kuon/pcb-pihat-pwr/README.md

## Simple power hat for the raspberry pi

This power hat provides 3A power to the raspberry pi from a 5-15V input with an
additional 5V 2A output.

Library footprint and symbols are from <https://github.com/goyman/pcb-kicad-lib>

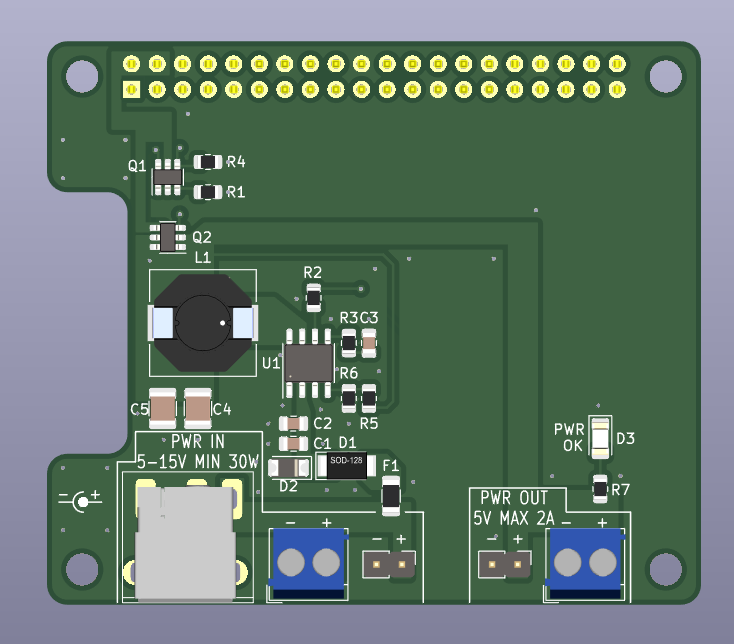
[picture p1: images/board.png]
board rev 1
