kuon/pcb-pihat-pwr/pcb-power-hat.kicad_pcb

## KiCad design pcb-power-hat.kicad_pcb (2022-10-22)

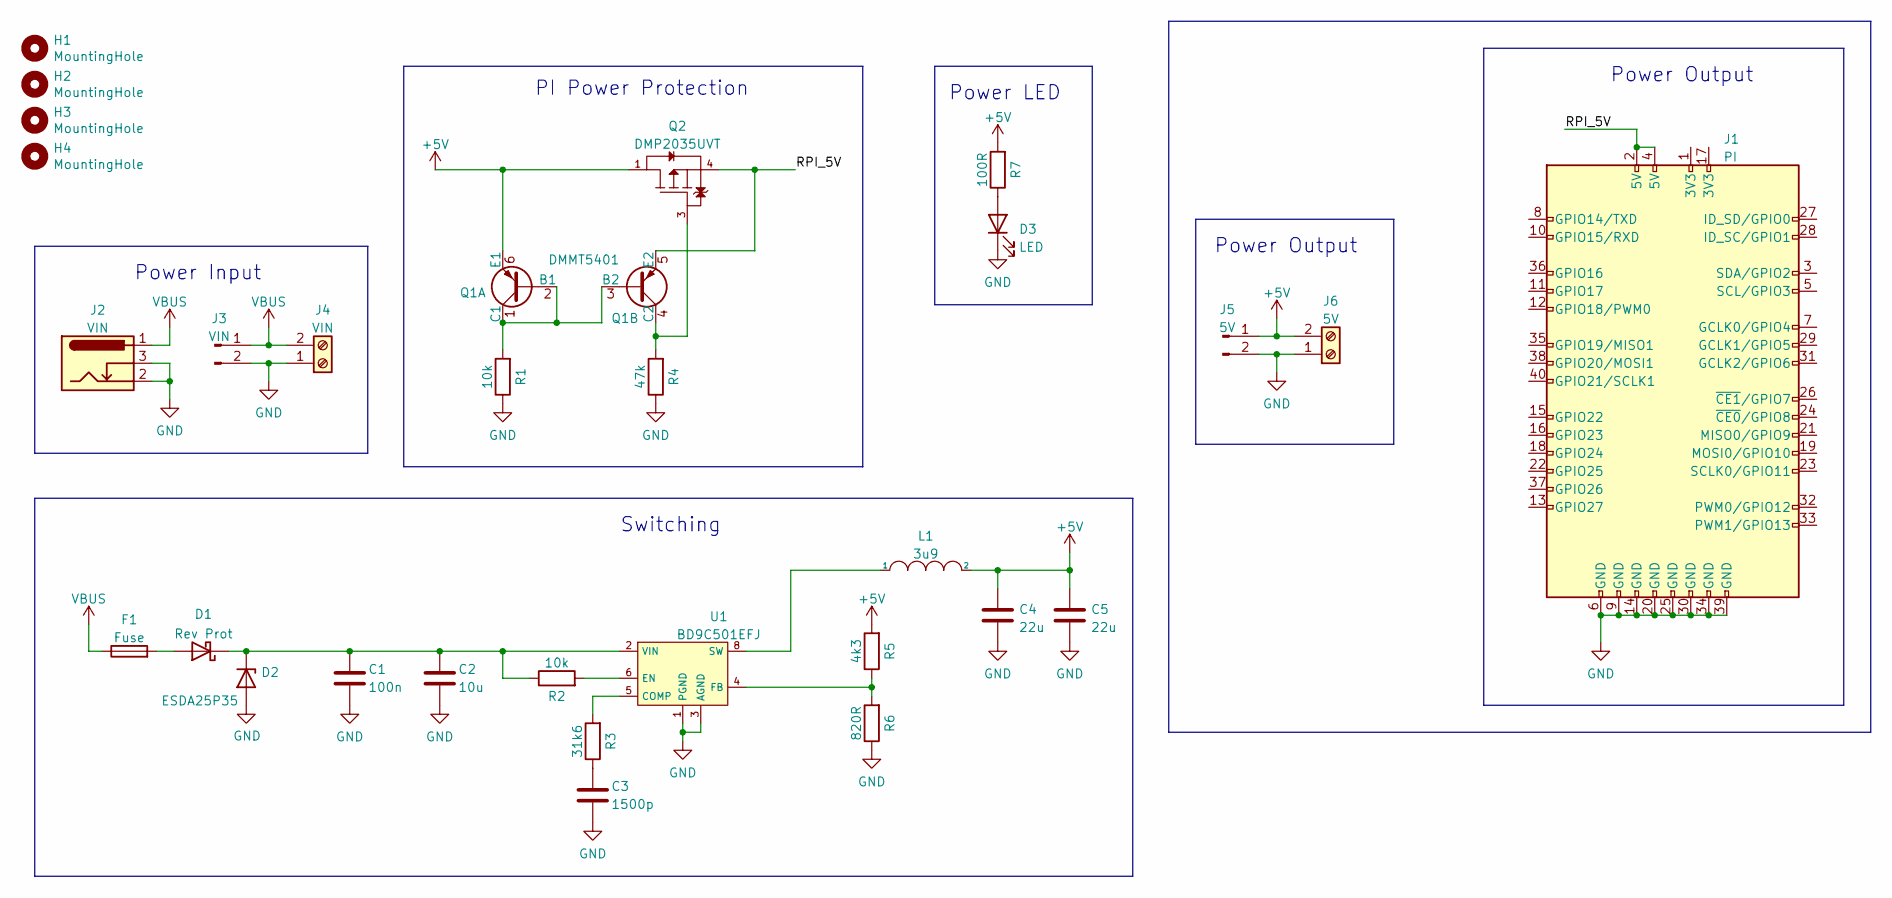
[picture p2: schematic pcb-power-hat.kicad_sch]

Parts:
C1: 100n; C_0805_2012Metric; MPN GCD21BR71H104KA01L
C2: 10u; C_0805_2012Metric; MPN GRM21BR61C106KE15K
C3: 1500p; C_0805_2012Metric; MPN C2012C0G2A152J060AA
C4, C5: 22u; C_0805_2012Metric; MPN CL21A226KOQNNNE
D1: Rev Prot; D_SOD-128; MPN PMEG10030ELPX
D2: ESDA25P35; QFN1610; MPN ESDA25P35-1U1M
D3: LED; LED_1206_3216Metric; MPN APTR3216-VFX
F1: Fuse; Fuse_1206_3216Metric; MPN 040705.5WRA
H1, H2, H3, H4: MountingHole; MountingHole_3.2mm_M3
J1: PI; PinSocket_2x20_P2.54mm_Vertical; MPN SSQ-120-03-T-D
J2: VIN; Barrel_Jack_54-00127; MPN 54-00127
J3: VIN; PinHeader_1x02_P2.54mm_Vertical
J4: VIN; TerminalBlock_4Ucon_1x02_P3.50mm_Horizontal; MPN 691103110002
J5: 5V; PinHeader_1x02_P2.54mm_Vertical
J6: 5V; TerminalBlock_4Ucon_1x02_P3.50mm_Horizontal; MPN 691103110002
L1: 3u9; L_10.4x10.4_H4.8; MPN #B966AS-3R9N=P3
Q1: DMMT5401; SOT-23-6; MPN DMMT5401-7-F
Q2: DMP2035UVT; SOT-23-6; MPN DMP2035UVT-7
R1, R2: 10k; R_0805_2012Metric; MPN ERJ-P06F1002V
R3: 31k6; R_0805_2012Metric; MPN RNCF0805DTE31K6
R4: 47k; R_0805_2012Metric; MPN RMCF0805FT47K0
R5: 4k3; R_0805_2012Metric; MPN RNCF0805DTE4K30
R6: 820R; R_0805_2012Metric; MPN RNCF0805DTE820R
R7: 100R; R_0805_2012Metric; MPN KTR10EZPF1000
U1: BD9C501EFJ; HTSOP-8-1EP_3.9x4.9mm_P1.27mm_EP2.4x3.2mm; MPN BD9C501EFJ-E2

Connections:
+5V: C4.1, C5.1, J5.1, J6.2, L1.2, Q1.6 (E1), Q2.1 (DRAIN), Q2.2 (DRAIN), Q2.5 (DRAIN), Q2.6 (DRAIN), R5.2, R7.2
/RPI_5V: J1.2 (5V), J1.4 (5V), Q1.5 (E2), Q2.4 (SOURCE)
GND: C1.2, C2.2, C3.2, C4.2, C5.2, D2.2 (A), D3.1 (K), J1.6 (GND), J1.9 (GND), J1.14 (GND), J1.20 (GND), J1.25 (GND), J1.30 (GND), J1.34 (GND), J1.39 (GND), J2.2, J2.3, J3.2, J4.1, J5.2, J6.1, R1.1, R4.1, R6.1, U1.1 (PGND), U1.3 (AGND)
unnamed: C1.1, C2.1, D1.1 (K), D2.1 (K), R2.1, U1.2 (VIN)
unnamed: C3.1, R3.1
unnamed: D1.2 (A), F1.2
unnamed: D3.2 (A), R7.1
unnamed: L1.1, U1.7 (SW), U1.8 (SW)
unnamed: Q1.1 (C1), Q1.2 (B1), Q1.3 (B2), R1.2
unnamed: Q1.4 (C2), Q2.3 (GATE), R4.2
unnamed: R2.2, U1.6 (EN)
unnamed: R3.2, U1.5 (COMP)
unnamed: R5.1, R6.2, U1.4 (FB)
VBUS: F1.1, J2.1, J3.1, J4.2

Notes on the sheet:
Power LED
Power Output
PI Power Protection
Switching
Power Input

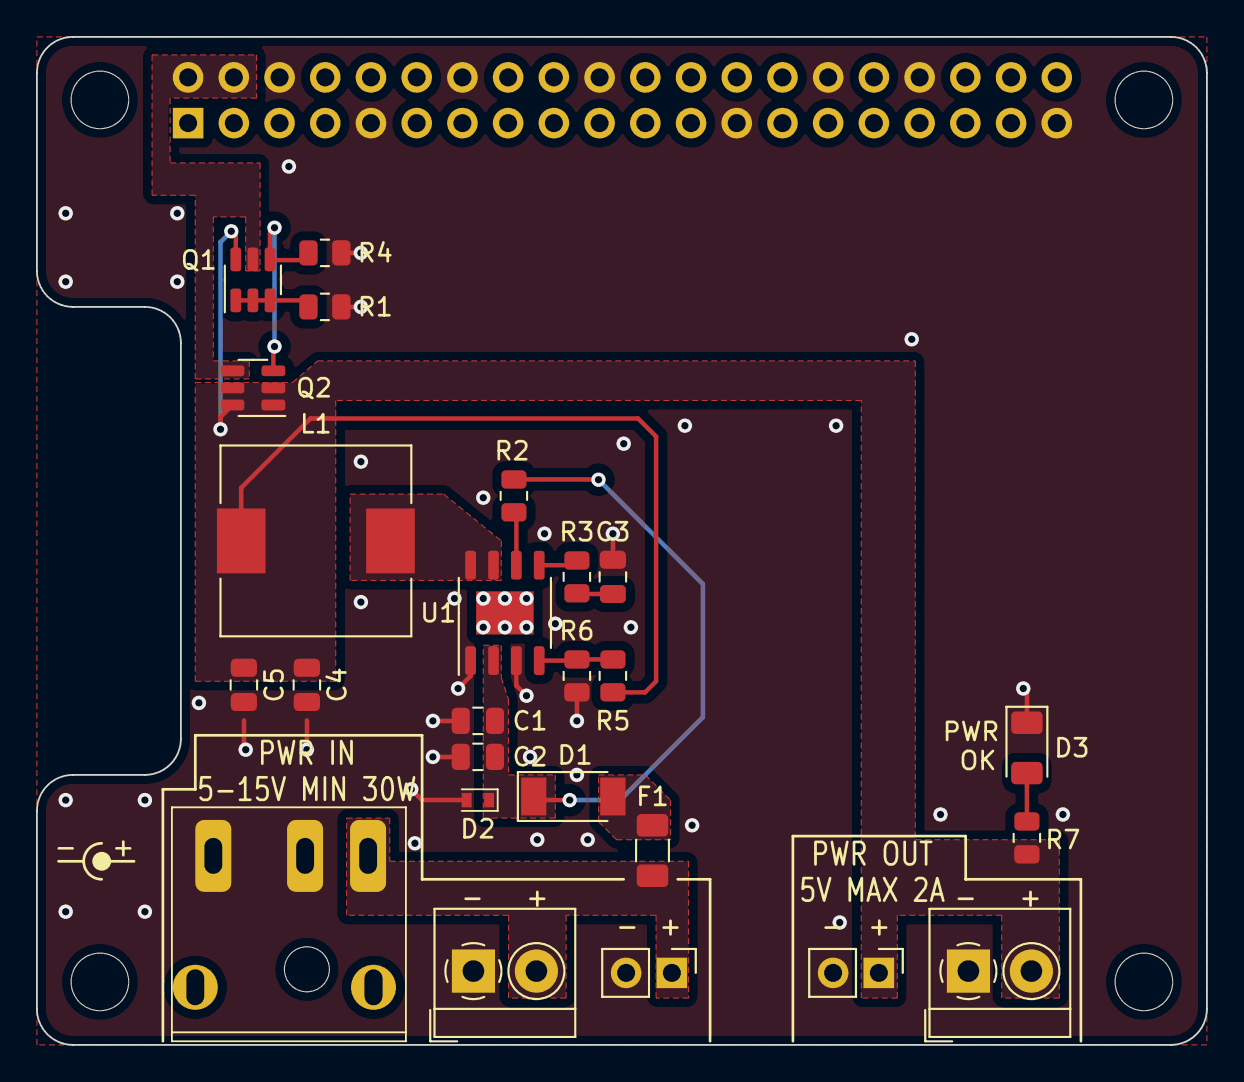
[picture p3: board pcb-power-hat.kicad_pcb from above]

Board: 2 copper layers, 65.0 x 56.0 mm, 30 parts (1 on the bottom side), 14 nets.
