kuon/pcb-pihat-pwr/(commit log)

2022-05-29 Rev 1
    [pcb-power-hat.kicad_pcb, pcb-power-hat.kicad_sch]
2022-05-29 Add board image
2022-06-02 Reduce resistor for violet LED as it has 3.3V voltage drop.
    [pcb-power-hat.kicad_sch]
2022-06-09 Fix TVS footprint
    [pcb-power-hat.kicad_pcb, pcb-power-hat.kicad_sch]
2022-10-22 Add IPN
    [pcb-power-hat.kicad_pcb, pcb-power-hat.kicad_sch]
